lss486558354-ship-it/scallion-washer-packer/scallion-packer/project/deploy/SKILL.md

1.生成文件后检查一次并汇报
2.时刻保持中文注释
3.确认调用的函数（类以及其他类似的）是真实存在的
4.完成任务后详细介绍使用流程：如需要先进行其他操作也全部告知，要求小白也可更据流程完成使用
5.遇到问题并解决后生成能解决类似问题的skill！！！（高优先级）
