lss486558354-ship-it/scallion-washer-packer/scallion-packer/tools/sm40bl_host/main.py

#!/usr/bin/env python3
# -*- coding: utf-8 -*-
"""
飞特 SM40BL-C001 等 RS485 总线舵机 — 控制上位机（仅发送）

依据公开资料整理（请以飞特最新 PDF 为准）：
  - 产品页：SM-40BL-C001，RS485 半双工异步串行、总线数据包通讯
  - 位置分辨率：0～4095 对应 360°（官网规格表）
  - 通讯速率：约 38400 bps～1 Mbps（以舵机内配置为准）
  - 协议帧与飞特《舵机协议手册-磁编码版本》一致：FF FF ID LEN INST 参数… CHK

硬件：SM40BL 为 RS485 电平，PC 侧请使用 USB-RS485 转换器（或飞特转接板），
 接到 A/B 差分线；GND 共地参考转换器说明。不可把普通 USB-TTL 直接当 RS485 用。

本程序只向串口写数据，不读回包。
"""

from __future__ import annotations

import sys
from typing import Optional

import serial
from serial.tools import list_ports

from PySide6.QtCore import Qt
from PySide6.QtWidgets import (
    QApplication,
    QCheckBox,
    QComboBox,
    QDoubleSpinBox,
    QFormLayout,
    QGridLayout,
    QGroupBox,
    QHBoxLayout,
    QLabel,
    QLineEdit,
    QMainWindow,
    QMessageBox,
    QPushButton,
    QSpinBox,
    QVBoxLayout,
    QWidget,
)

# —— 飞特总线协议（与 SCS/SMS 磁编码常用写法一致，具体寄存器以该型号内存表为准）——
SCS_INST_WRITE = 0x03
ADDR_GOAL_BLOCK = 0x2A
ADDR_GOAL_SPEED = 0x2E
POS_MAX = 4095


def scs_checksum(servo_id: int, length: int, inst: int, addr_and_data: bytes) -> int:
    s = servo_id + length + inst
    for b in addr_and_data:
        s += b
    return (~s) & 0xFF


def build_write_packet(servo_id: int, start_addr: int, data: bytes) -> bytes:
    if not (0 <= servo_id <= 253):
        raise ValueError("ID 应在 0～253")
    inst = SCS_INST_WRITE
    addr_and_data = bytes([start_addr]) + data
    length = 1 + len(addr_and_data) + 1
    chk = scs_checksum(servo_id, length, inst, addr_and_data)
    return bytes([0xFF, 0xFF, servo_id, length, inst]) + addr_and_data + bytes([chk])
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
