lss486558354-ship-it/scallion-washer-packer/(commit log)

2026-06-13 大葱智洗打包机 - 初始提交
    [1.csv, 10.csv, 11.csv, 2.csv, 3.csv, 4.csv, 5.csv, 6.csv]
2026-06-13 重命名文件夹: 最后一脚 -> scallion-packer
    [1.csv, 10.csv, 11.csv, 2.csv, 3.csv, 4.csv, 5.csv, 6.csv]
2026-10-08 docs: 补充根目录 README 与 MIT 许可证
    - README 面向访客：系统架构、四路串口分工、工艺状态机、通信协议、工具链
    - 记录国一获奖信息（MEICC02IEIDC2026-JB1-038）与团队署名
    - 如实记录 7 项技术债（main.c 1663 行巨型函数、37 个一次性调试脚本、文档过时等）
    - LICENSE 以 MIT 覆盖自有代码，并声明 ST 标准外设库遵循原许可
2026-10-08 chore: 清理开发期杂物，补 .gitignore 规则
    删除 44 个文件：
    - project/User/ 下 37 个一次性调试脚本（debug_check2~8.py、apply_v2/v3.py、
    show_indent.py 等），系开发期用脚本批量改 main.c 的残渣，与固件无关
    - scallion-packer/ 根目录 4 个同类脚本（apply_changes.py、fix_main.py 等）
    - 3 个 .uvguix.* Keil 布局文件，内含本地 Windows 用户名与目录结构
    保留 servo_debug_tool.py（舵机调试助手，1053 行）、test_speed_encoding.py
    （协议编码验证）、voice_protocol.py（上位机通信实现）等真实工具。
    .gitignore 补充 *.uvguix.* 与 .backups/
    删除前已备份至 .backups/20261008_清理杂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
2026-10-08 docs: 修正速度编码实测样本的数值错误
    原文写 0x0466 (dec=1150 = 1024+126)，三个数互相矛盾：
    0x0466 = 1126，而 1024+126 = 1150 = 0x047E，按 speed=-134 算则是 1158 = 0x0486。
    查 tools/11.csv 原始 TX 帧 FFFF0803022E0486C1 得真值：
    数据字节 04 86 → 0x0486 = 1158 = 1024+134，与 speed=-134 自洽。
    注：这个错误数字一直掩盖着 0x2E 字节序的实测证据 ——
    帧内数据高位在前（04 86），即大端，与本文档 4.3 节的说法一致。
